BeshoySameh1/GRC-2026-ROV-BUE/ROV/WIN_20251121_15_10_11_Pro.jpg

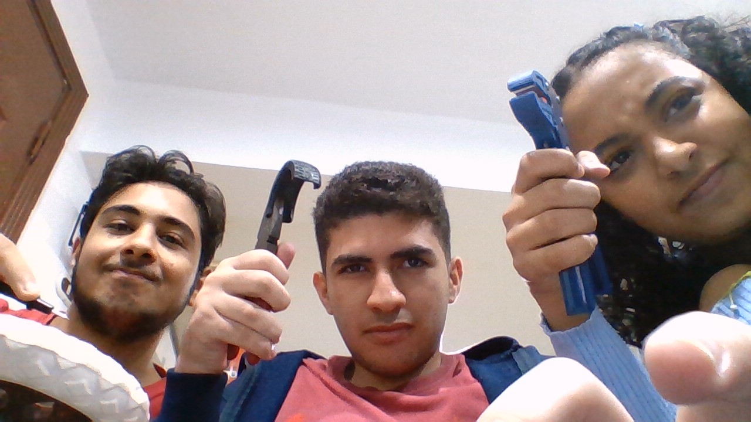
ROV/WIN_20251121_15_10_11_Pro.jpg
