BeshoySameh1/GRC-2026-ROV-BUE/ROV-Elec/NEW/Cntrol + comm/main control/silk.pdf

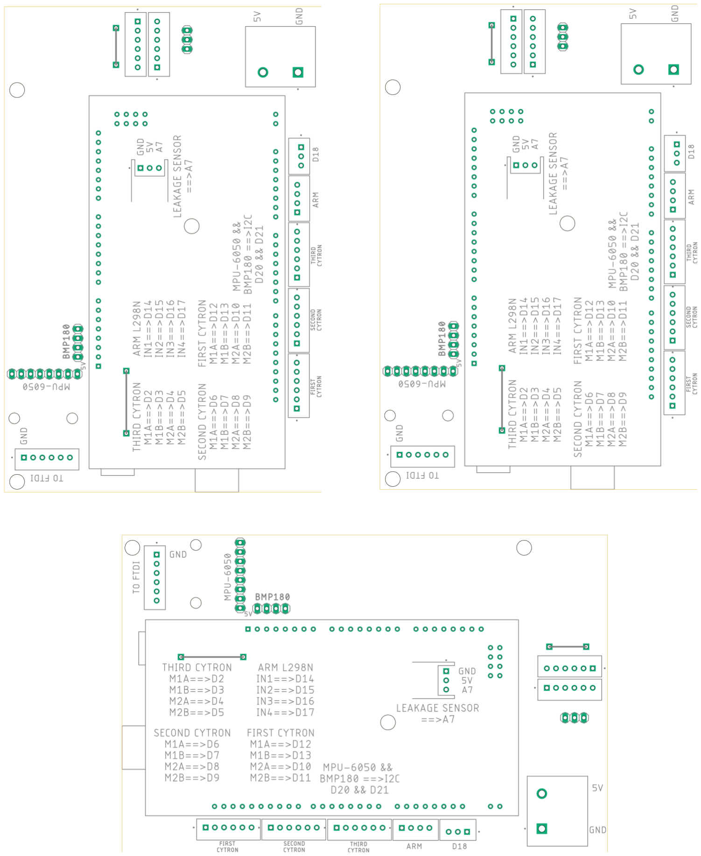
[picture p15: page 1]
