BeshoySameh1/GRC-2026-ROV-BUE/ROV-Elec/NEW/Cntrol + comm/main control/tracks.pdf

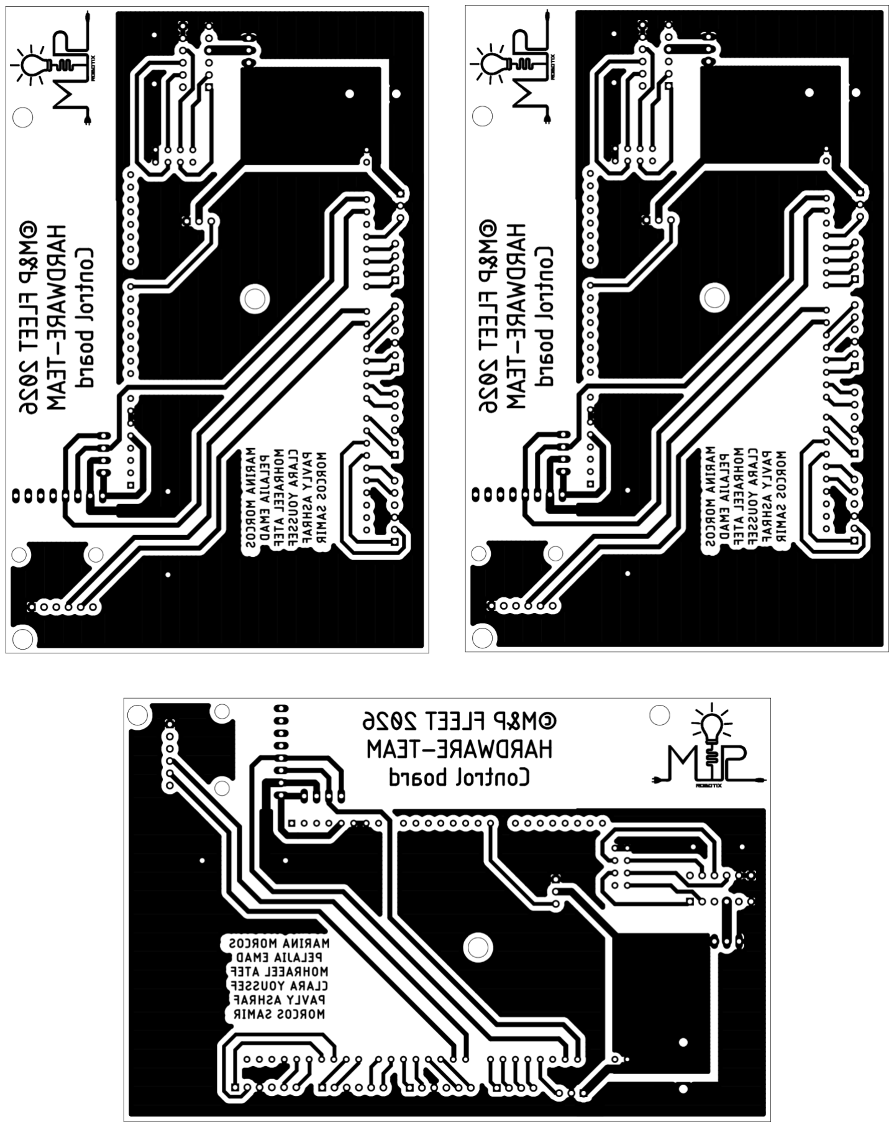
[picture p16: page 1]
