BeshoySameh1/GRC-2026-ROV-BUE/Cost Analysis (1).pdf

### Cost Overview

The total cost for the ROV components is 29,000 EGP and 580 USD, ensuring a
competitive pricing strategy for the Egyptian market in robotics applications.

### Component Breakdown

Major categories include
Propulsion, Electronics,
Cameras, Mechanical, Tether, and Manipulator, which together contribute to the effective performance of the ROV in
various underwater tasks.

### Market Adaptability

This cost analysis reflects local market conditions and allows for strategic adjustments to pricing, ensuring that our ROV remains accessible and
appealing to potential clients in Egypt.

# ROV Cost Analysis

### Detailed breakdown for Egypt market

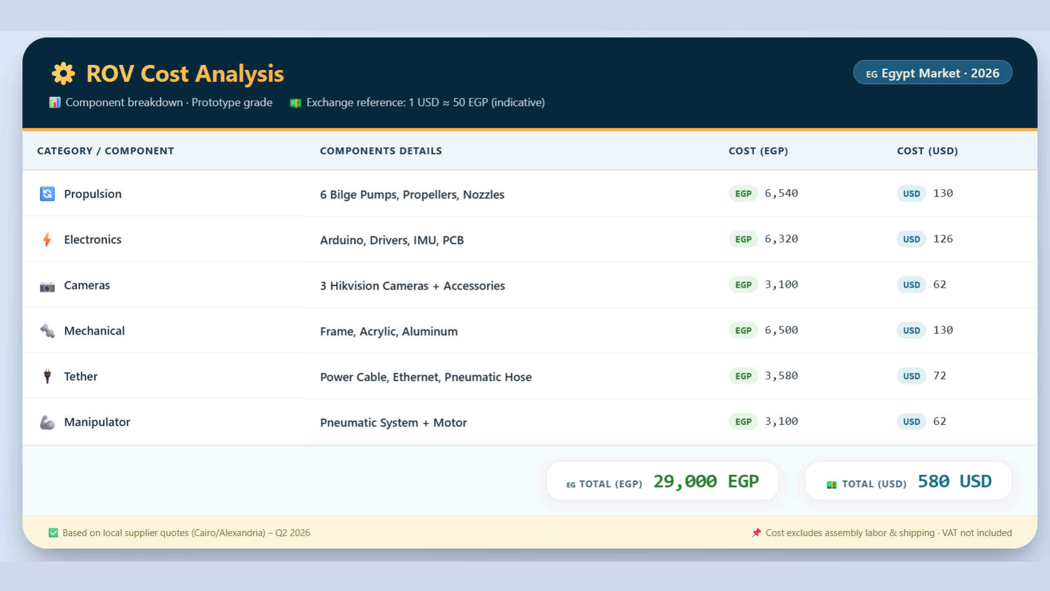
[picture p17: page 2]
