BeshoySameh1/GRC-2026-ROV-BUE/ROV-Elec/NEW/Cntrol + comm/spi module board/silk.pdf

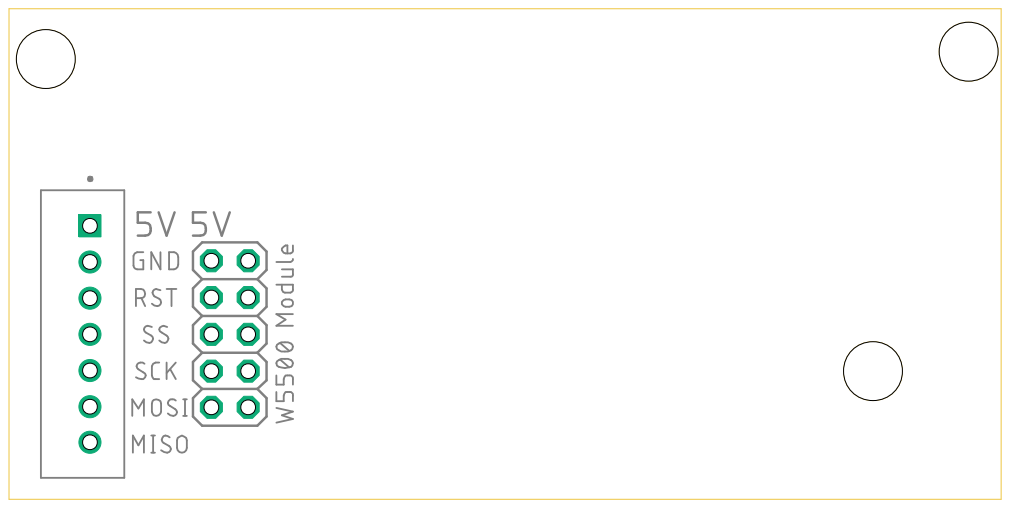
[picture p18: page 1]
