BeshoySameh1/GRC-2026-ROV-BUE/ROV-Elec/NEW/Cntrol + comm/spi module board/tracks.pdf

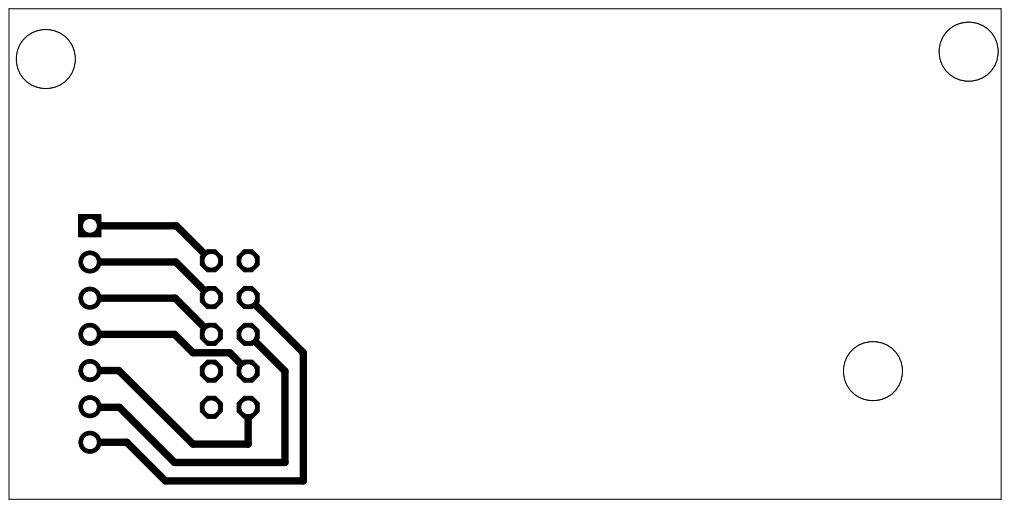
[picture p19: page 1]
