BeshoySameh1/GRC-2026-ROV-BUE/ROV-Elec/NEW/POWER/Main power/silk.pdf

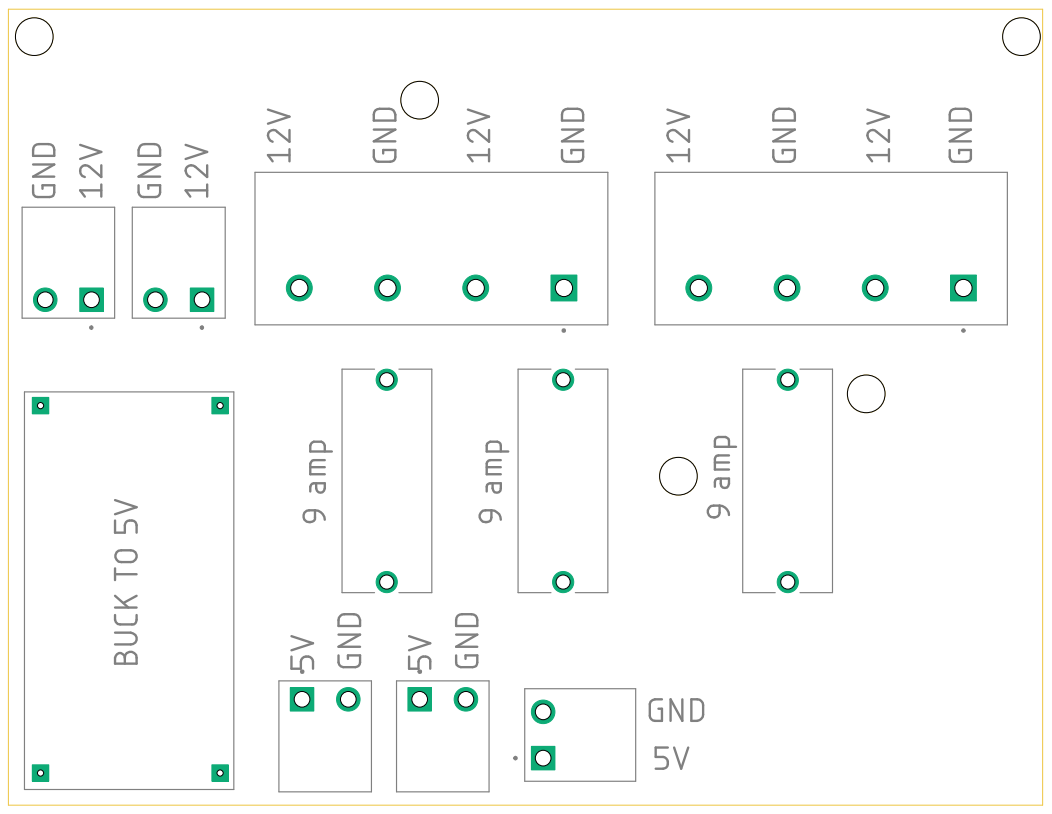
[picture p20: page 1]
