BeshoySameh1/GRC-2026-ROV-BUE/ROV-Elec/NEW/POWER/Main power/tracks.pdf

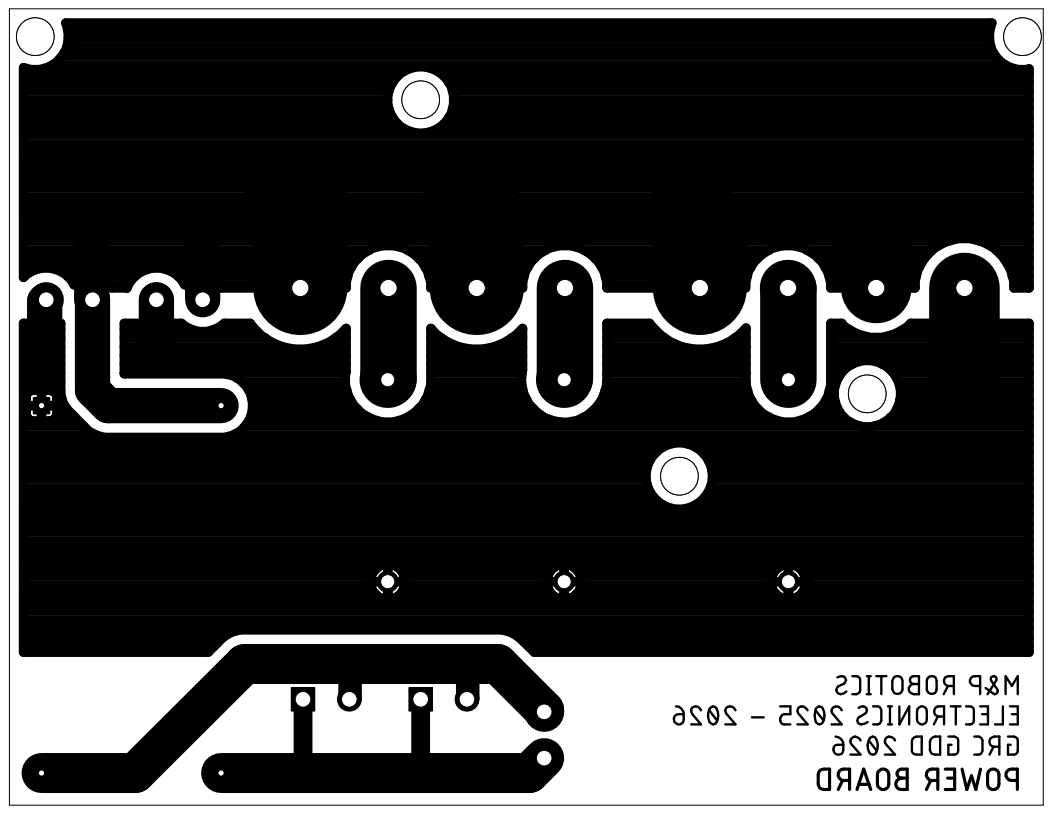
[picture p21: page 1]
