BeshoySameh1/GRC-2026-ROV-BUE/ROV-Elec/NEW/POWER/Camera power and board/at station/silk.pdf

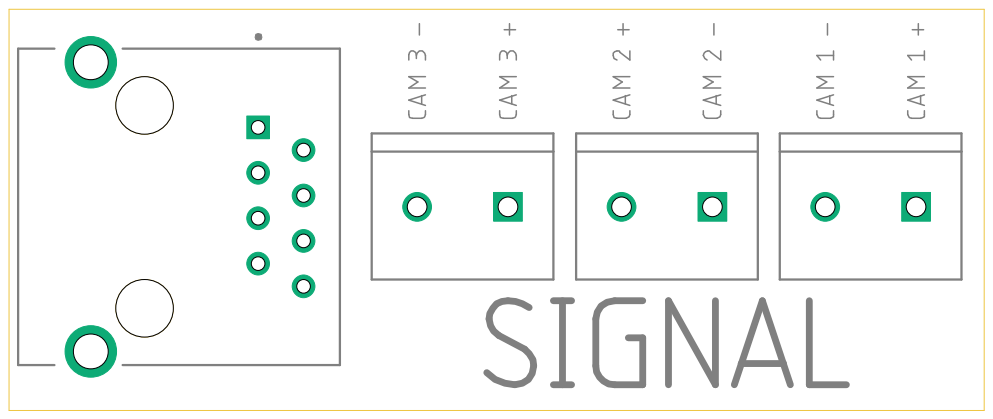
[picture p22: page 1]
