BeshoySameh1/GRC-2026-ROV-BUE/ROV-Elec/NEW/POWER/Camera power and board/at station/tracks.pdf

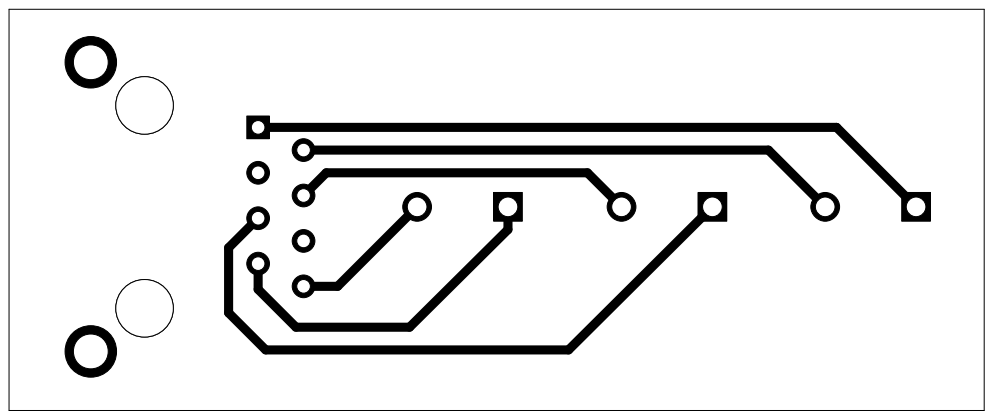
[picture p23: page 1]
