BeshoySameh1/GRC-2026-ROV-BUE/ROV-Elec/NEW/POWER/Camera power and board/in rov/silk.pdf

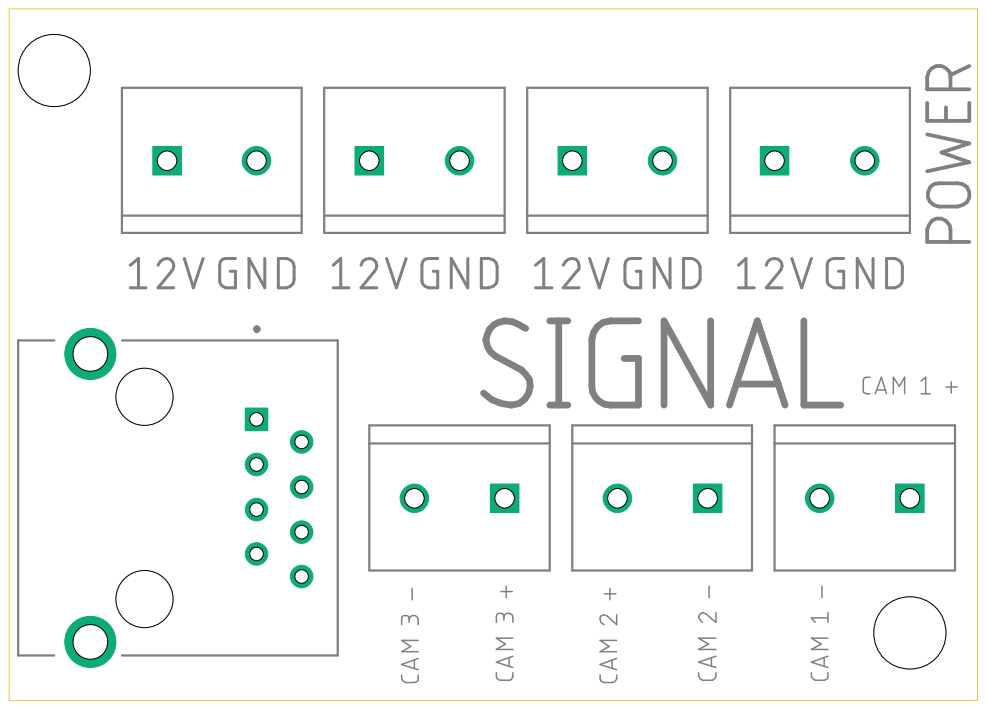
[picture p24: page 1]
