BeshoySameh1/GRC-2026-ROV-BUE/ROV-Elec/NEW/POWER/Camera power and board/in rov/tracks.pdf

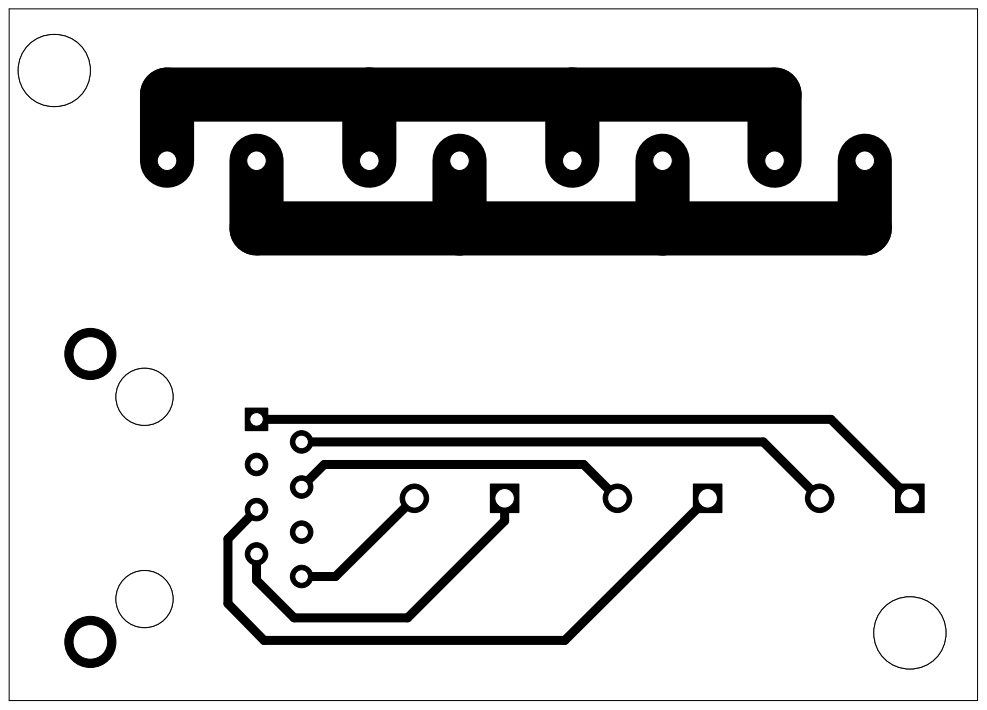
[picture p25: page 1]
