BeshoySameh1/GRC-2026-ROV-BUE/ROV/comm.brd

## EAGLE design ROV/comm.brd (2026-06-27)

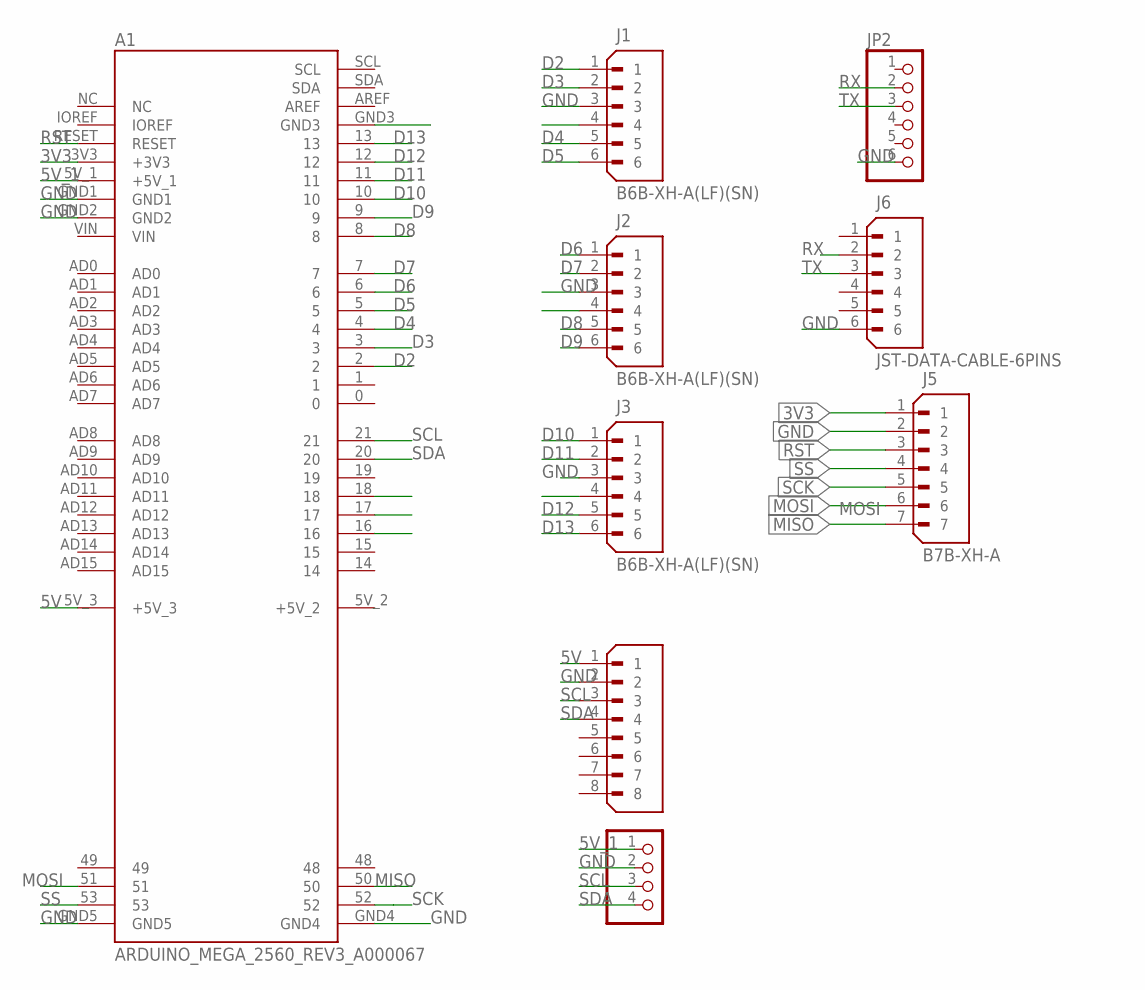
[picture p26: schematic comm.sch]

Parts:
A1: ARDUINO_MEGA_2560_REV3_A000067; ARDUINO_ARDUINO_MEGA_2560_REV3_A000067
J1, J2, J3: B6B-XH-A(LF)(SN); JST_B6B-XH-A(LF)(SN)
J4: B8B-XH-A(LF)(SN); JST_B8B-XH-A(LF)(SN)
J5: B7B-XH-A; JST_B7B-XH-A
J6: JST-DATA-CABLE-6PINS; JST_B6B-XH-A(LF)(SN)
JP1: PINHD-1X4; 1X04
JP2: PINHD-1X6; 1X06

Connections:
3V3: A1.3V3 (+3V3), J5.1
5V: A1.5V_3 (+5V_3), J4.1
5V_1: A1.5V_1 (+5V_1), JP1.1
D2: A1.2, J1.1
D3: A1.3, J1.2
D4: A1.4, J1.5
D5: A1.5, J1.6
D6: A1.6, J2.1
D7: A1.7, J2.2
D8: A1.8, J2.5
D9: A1.9, J2.6
D10: A1.10, J3.1
D11: A1.11, J3.2
D12: A1.12, J3.4, J3.5
D13: A1.13, J3.6
GND: A1.GND1, A1.GND2, A1.GND4, A1.GND5, J1.3, J2.3, J3.3, J4.2, J5.2, J6.6, JP1.2, JP2.6
MISO: A1.50, J5.7
MOSI: A1.51, J5.6
RST: A1.RESET, J5.3
RX: J6.2, JP2.2
SCK: A1.52, J5.5
SCL: A1.21, J4.3, JP1.3
SDA: A1.20, J4.4, JP1.4
SS: A1.53, J5.4
TX: J6.3, JP2.3

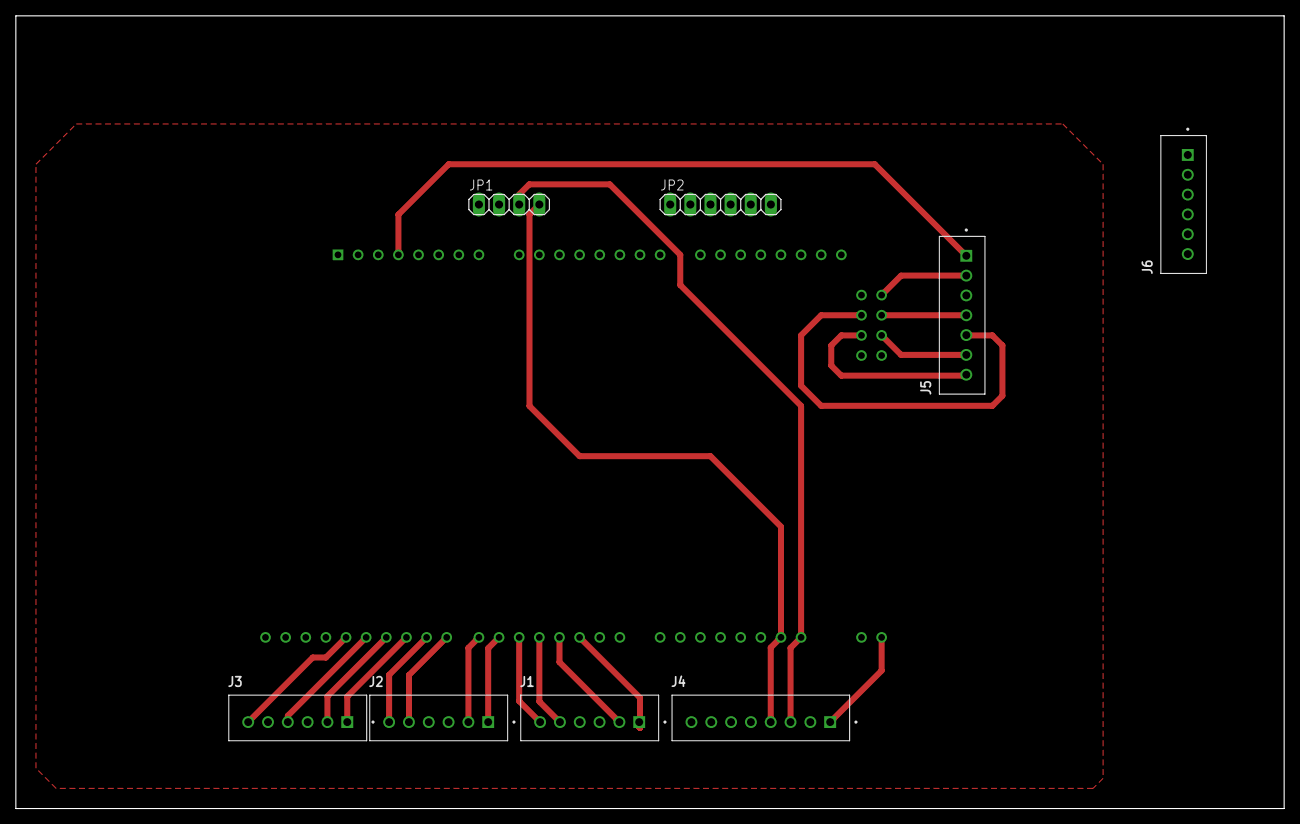
[picture p27: board comm.brd from above]

Board: 2 copper layers, 160.0 x 100.0 mm, 9 parts (1 on the bottom side), 25 nets.
