BeshoySameh1/GRC-2026-ROV-BUE/ROV/cam/untitled.brd

## EAGLE design ROV/cam/untitled.brd (2026-06-27)

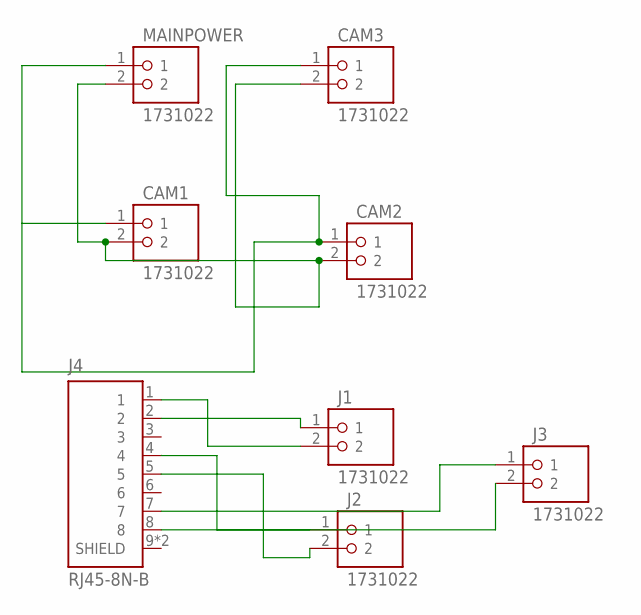
[picture p28: schematic untitled.sch]

Parts:
CAM1, CAM2, CAM3: 1731022; PHOENIX_1731022
J1, J2, J3: 1731022; PHOENIX_1731022
J4: RJ45-8N-B; TE_RJ45-8N-B
MAINPOWER: 1731022; PHOENIX_1731022

Connections:
12V: CAM1.1, CAM2.1, CAM3.1, MAINPOWER.1
GND: CAM1.2, CAM2.2, CAM3.2, MAINPOWER.2
unnamed: J1.1, J4.2
unnamed: J1.2, J4.1
unnamed: J2.1, J4.4
unnamed: J2.2, J4.5
unnamed: J3.1, J4.7
unnamed: J3.2, J4.8

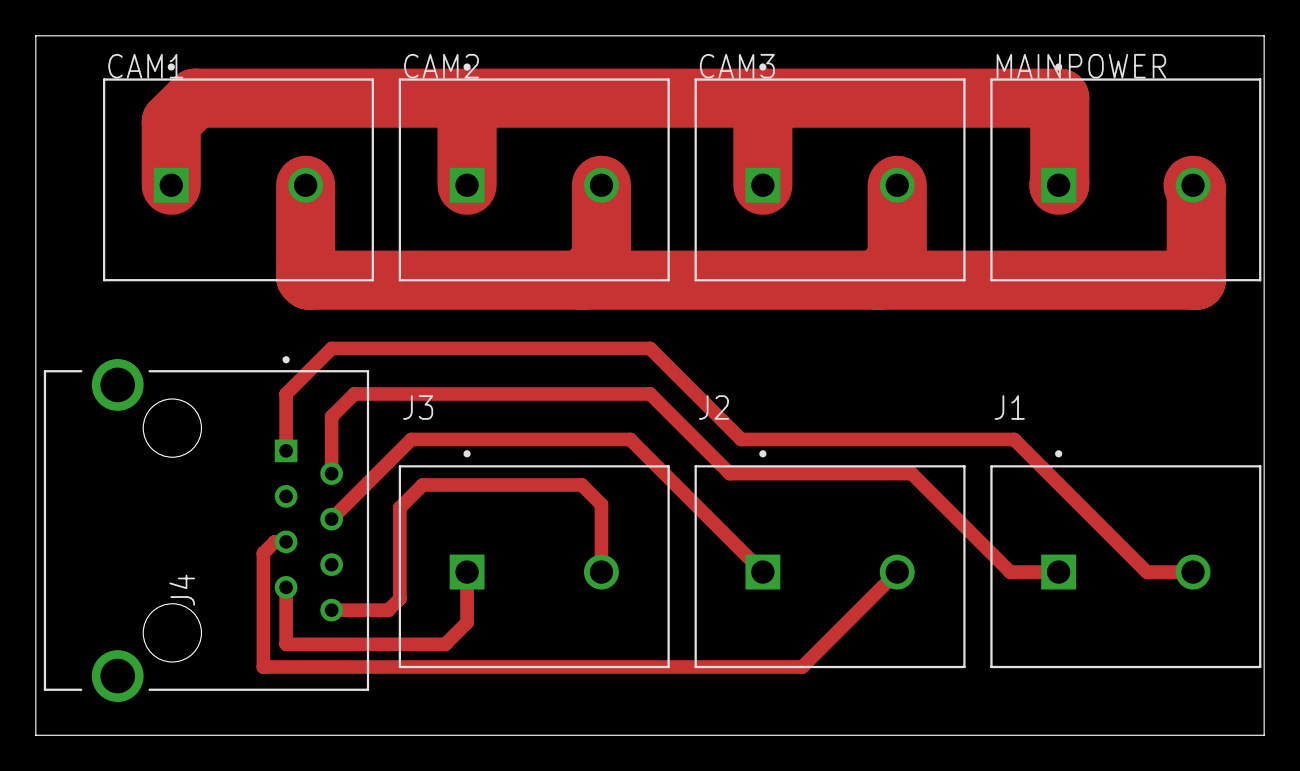
[picture p29: board untitled.brd from above]

Board: 2 copper layers, 68.6 x 39.0 mm, 8 parts (0 on the bottom side), 8 nets.
