BeshoySameh1/GRC-2026-ROV-BUE/ROV/power.brd

## EAGLE design ROV/power.brd (2026-06-27)

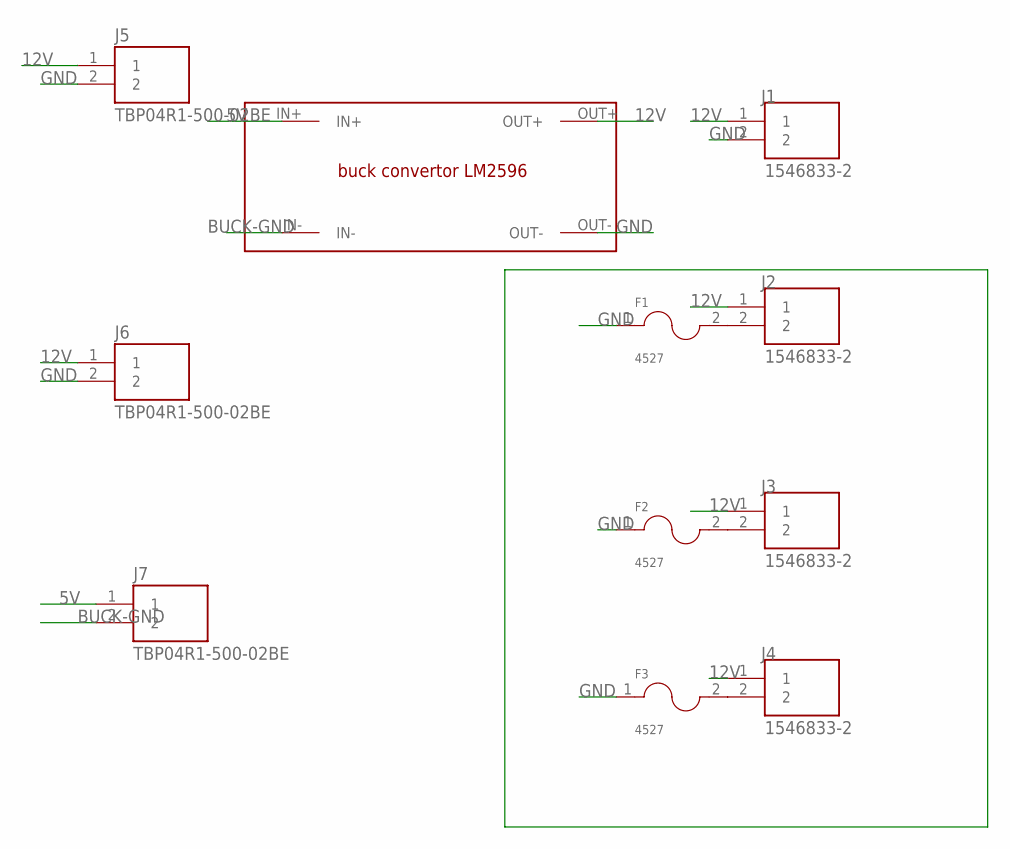
[picture p30: schematic power.sch]

Parts:
F1, F2, F3: 4527; FUSE_4527
J1, J2, J3, J4: 1546833-2; TE_1546833-2
J5, J6, J7: TBP04R1-500-02BE; CUI_TBP04R1-500-02BE
U$1: LM2596

Connections:
5V: J7.1, U$1.IN+
12V: J1.1, J2.1, J3.1, J4.1, J5.1, J6.1, U$1.OUT+
BUCK-GND: J7.2, U$1.IN-
GND: F1.1, F2.1, F3.1, J1.2, J5.2, J6.2, U$1.OUT-
unnamed: F1.2, J2.2
unnamed: F2.2, J3.2
unnamed: F3.2, J4.2

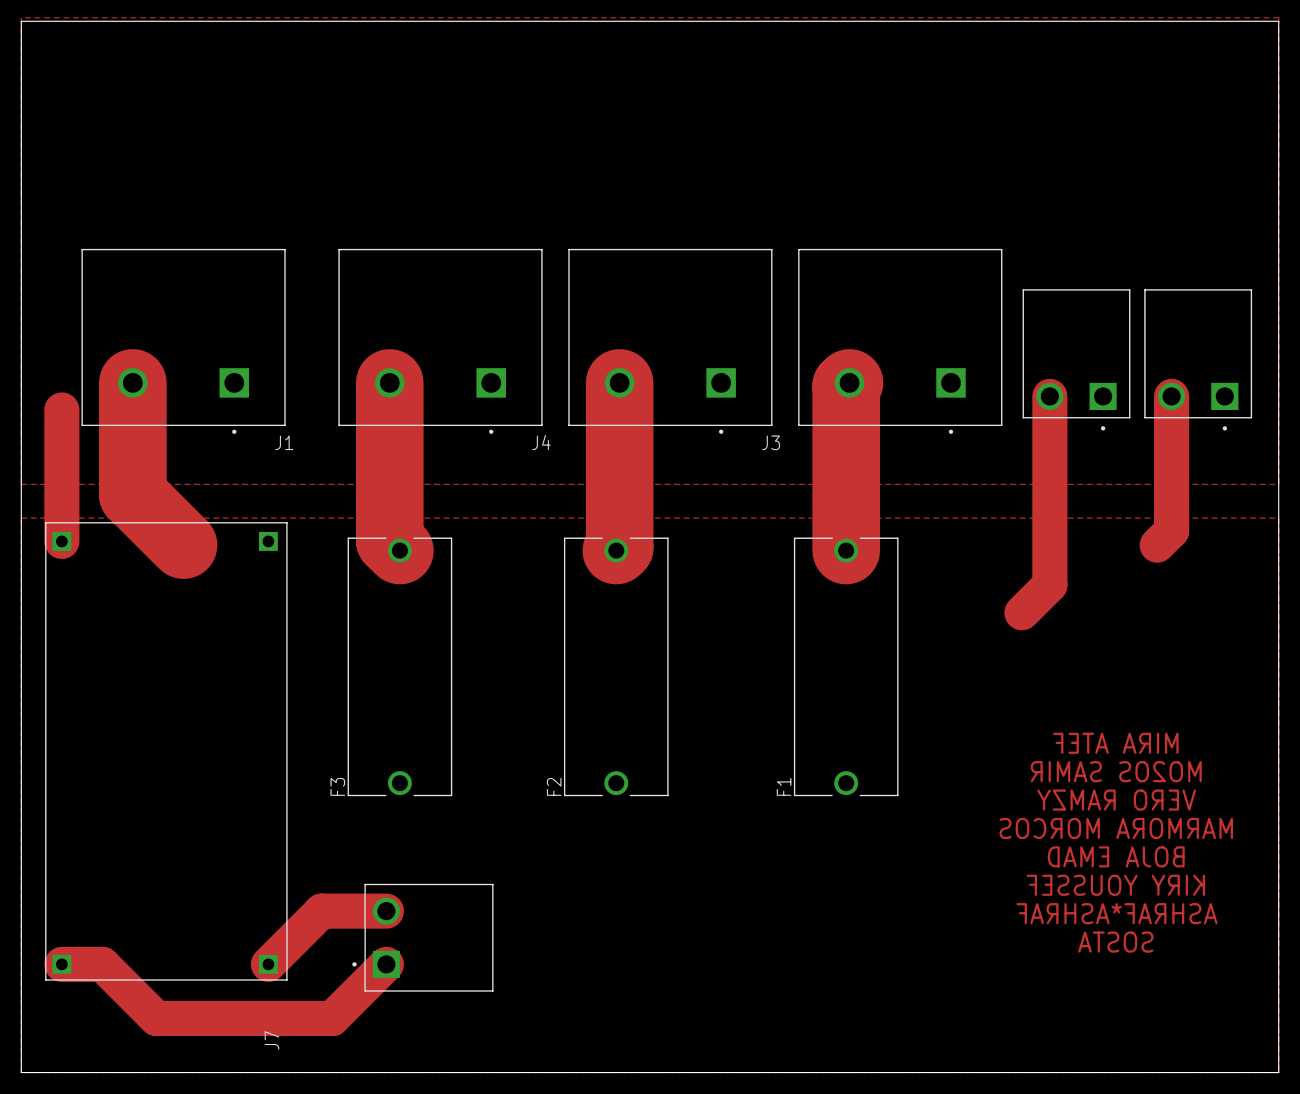
[picture p31: board ROV/power.brd from above]

Board: 2 copper layers, 118.1 x 98.7 mm, 11 parts (0 on the bottom side), 7 nets.
