BeshoySameh1/GRC-2026-ROV-BUE/ROV-Elec/NEW/POWER/Camera power and board/at station/camera.brd

## EAGLE design ROV-Elec/NEW/POWER/Camera power and board/at station/camera.brd (2026-06-27)

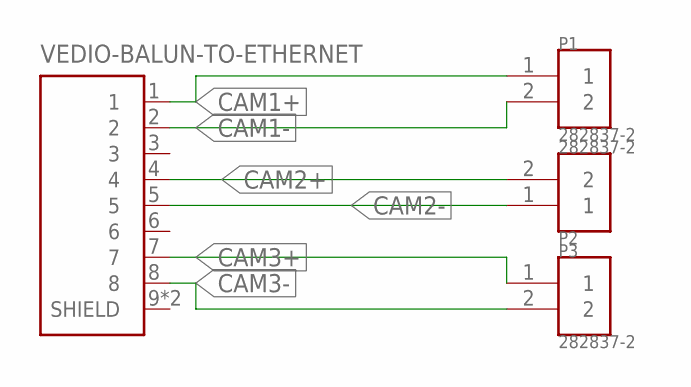
[picture p32: schematic camera.sch, vedio balun to ethernet]

Parts:
P1, P2, P3: 282837-2; TE_282837-2
VEDIO-BALUN-TO-ETHERNET: RJ45-8N-B; TE_RJ45-8N-B

Connections:
CAM1+: P1.1, VEDIO-BALUN-TO-ETHERNET.1
CAM1-: P1.2, VEDIO-BALUN-TO-ETHERNET.2
CAM2+: P2.2, VEDIO-BALUN-TO-ETHERNET.4
CAM2-: P2.1, VEDIO-BALUN-TO-ETHERNET.5
CAM3+: P3.1, VEDIO-BALUN-TO-ETHERNET.7
CAM3-: P3.2, VEDIO-BALUN-TO-ETHERNET.8

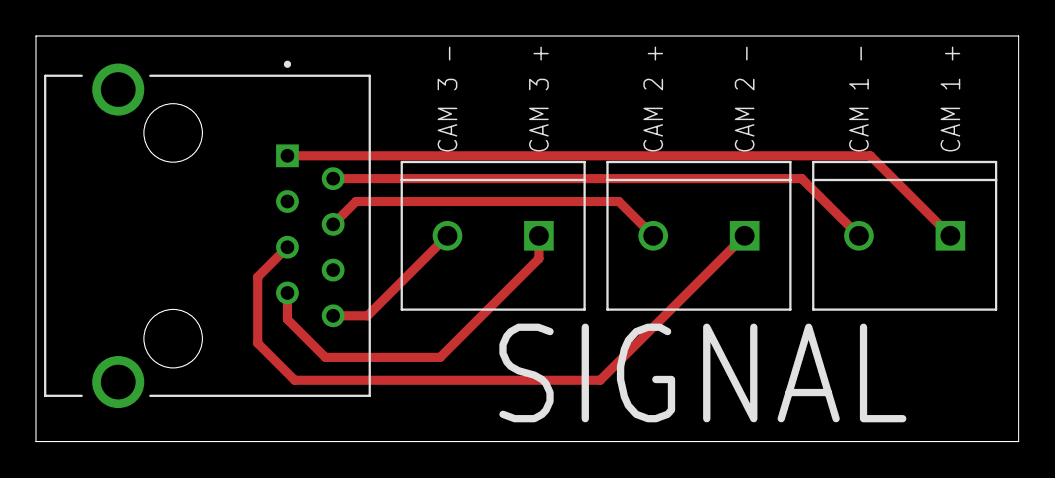
[picture p33: board camera.brd from above]

Board: 2 copper layers, 54.6 x 22.5 mm, 4 parts (0 on the bottom side), 6 nets.
