BeshoySameh1/GRC-2026-ROV-BUE/ROV-Elec/NEW/POWER/Main power/power.brd

## EAGLE design ROV-Elec/NEW/POWER/Main power/power.brd (2026-06-27)

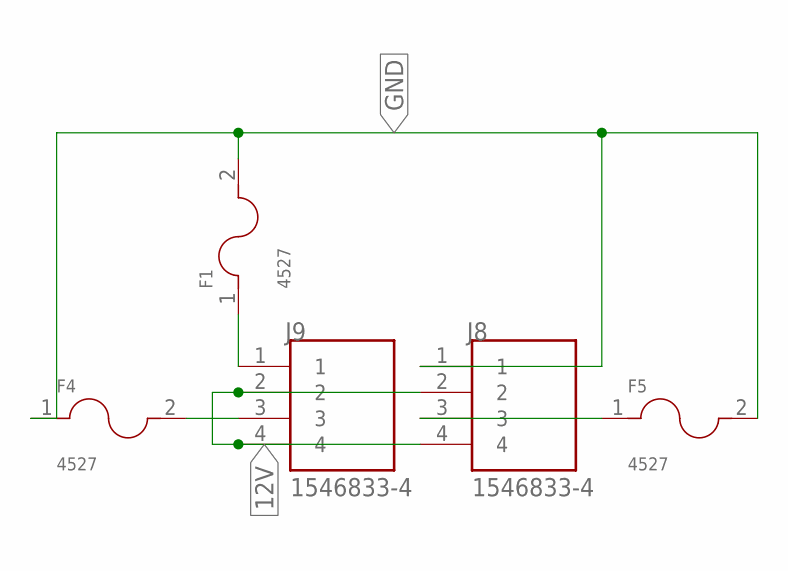
[picture p34: schematic power.sch, sheet 2, thrusters power]

Parts:
F1, F4, F5: 4527; FUSE_4527
J8, J9: 1546833-4; TE_1546833-4

Connections:
12V: J8.2, J8.4, J9.2, J9.4; also elsewhere on the board
GND: F1.2, F4.1, F5.2, J8.1; also elsewhere on the board
unnamed: F4.2, J9.3
unnamed: F5.1, J8.3
unnamed: F1.1, J9.1

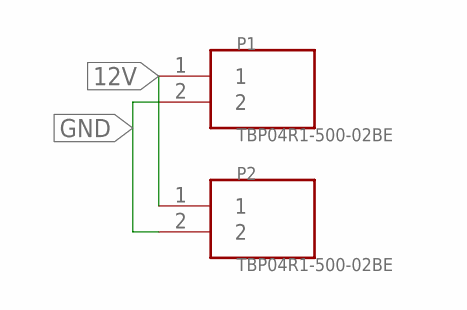
[picture p35: schematic power.sch, sheet 3, arm power + cameras power]

Parts:
P1, P2: TBP04R1-500-02BE; CUI_TBP04R1-500-02BE

Connections:
12V: P1.1, P2.1; also elsewhere on the board
GND: P1.2, P2.2; also elsewhere on the board

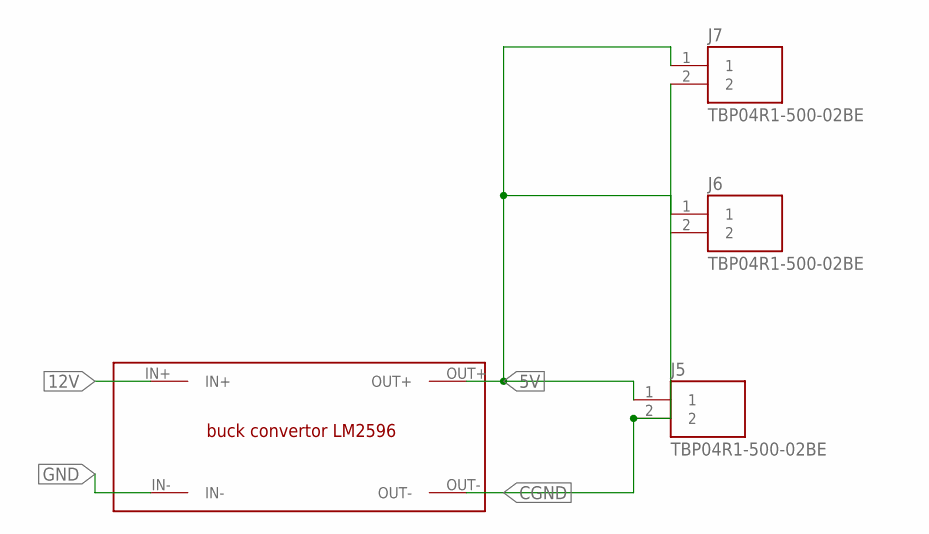
[picture p36: schematic power.sch, sheet 4, control power]

Parts:
J5, J6, J7: TBP04R1-500-02BE; CUI_TBP04R1-500-02BE
U$1: LM2596

Connections:
5V: J5.1, J6.1, J7.1, U$1.OUT+
12V: U$1.IN+; also elsewhere on the board
CGND: J5.2, J6.2, J7.2, U$1.OUT-
GND: U$1.IN-; also elsewhere on the board

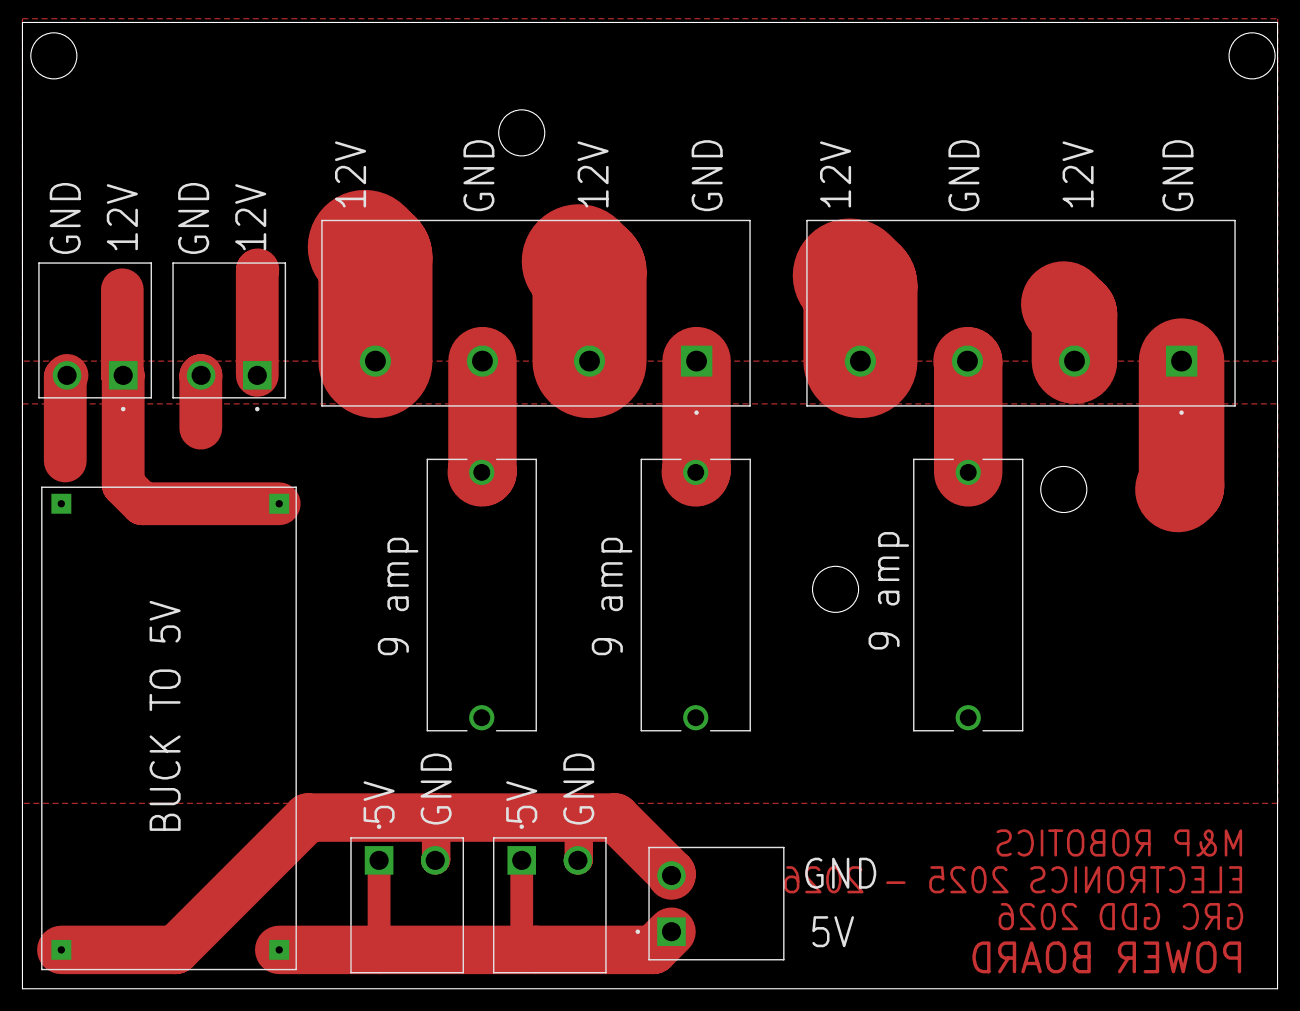
[picture p37: board ROV-Elec/NEW/POWER/Main power/power.brd from above]

Board: 2 copper layers, 111.7 x 86.0 mm, 11 parts (0 on the bottom side), 7 nets.
