BeshoySameh1/GRC-2026-ROV-BUE/ROV-Elec/NEW/Cntrol + comm/main control/coaches.brd

## EAGLE design ROV-Elec/NEW/Cntrol + comm/main control/coaches.brd (2026-06-27)

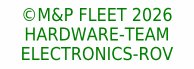
[picture p38: schematic coaches.sch, sheet 1, BIO]

Notes on the sheet:
©M&P FLEET 2026 HARDWARE-TEAM ELECTRONICS-ROV

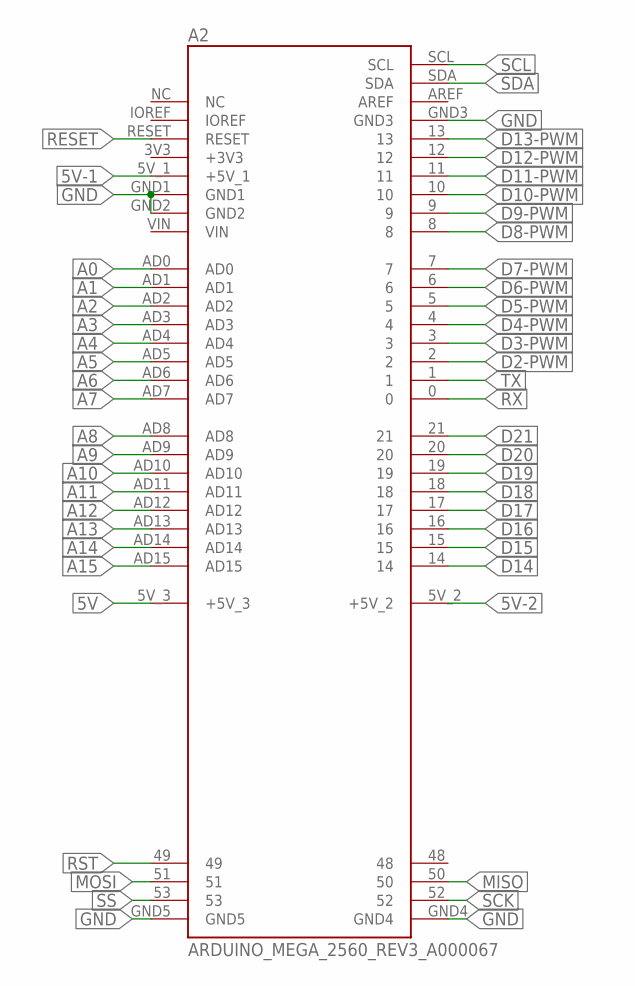
[picture p39: schematic coaches.sch, sheet 2, ARDUINO MEGA]

Parts:
A2: ARDUINO_MEGA_2560_REV3_A000067; ARDUINO_ARDUINO_MEGA_2560_REV3_A000067

Connections:
5V: A2.5V_3 (+5V_3); also elsewhere on the board
5V-1: A2.5V_1 (+5V_1); also elsewhere on the board
5V-2: A2.5V_2 (+5V_2)
A0: A2.AD0
A1: A2.AD1
A2: A2.AD2
A3: A2.AD3
A4: A2.AD4
A5: A2.AD5
A6: A2.AD6
A7: A2.AD7; also elsewhere on the board
A8: A2.AD8
A9: A2.AD9
A10: A2.AD10
A11: A2.AD11
A12: A2.AD12
A13: A2.AD13
A14: A2.AD14
A15: A2.AD15
D2-PWM: A2.2; also elsewhere on the board
D3-PWM: A2.3; also elsewhere on the board
D4-PWM: A2.4; also elsewhere on the board
D5-PWM: A2.5; also elsewhere on the board
D6-PWM: A2.6; also elsewhere on the board
D7-PWM: A2.7; also elsewhere on the board
D8-PWM: A2.8; also elsewhere on the board
D9-PWM: A2.9; also elsewhere on the board
D10-PWM: A2.10; also elsewhere on the board
D11-PWM: A2.11; also elsewhere on the board
D12-PWM: A2.12; also elsewhere on the board
D13-PWM: A2.13; also elsewhere on the board
D14: A2.14; also elsewhere on the board
D15: A2.15; also elsewhere on the board
D16: A2.16; also elsewhere on the board
D17: A2.17; also elsewhere on the board
D18: A2.18; also elsewhere on the board
D19: A2.19
D20: A2.20; also elsewhere on the board
D21: A2.21; also elsewhere on the board
GND: A2.GND1, A2.GND2, A2.GND3, A2.GND4, A2.GND5; also elsewhere on the board
MISO: A2.50; also elsewhere on the board
MOSI: A2.51; also elsewhere on the board
RESET: A2.RESET
RST: A2.49; also elsewhere on the board
RX: A2.0; also elsewhere on the board
SCK: A2.52; also elsewhere on the board
SCL: A2.SCL
SDA: A2.SDA
SS: A2.53; also elsewhere on the board
TX: A2.1; also elsewhere on the board

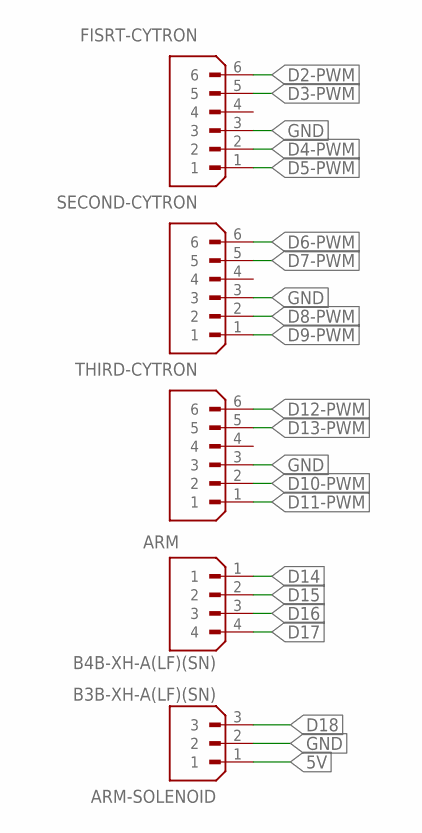
[picture p40: schematic coaches.sch, sheet 3, Motors]

Parts:
ARM: B4B-XH-A(LF)(SN); JST_B4B-XH-A(LF)(SN)
ARM-SOLENOID: B3B-XH-A(LF)(SN); JST_B3B-XH-A(LF)(SN)
FISRT-CYTRON: B6B-XH-A(LF)(SN); JST_B6B-XH-A(LF)(SN)
SECOND-CYTRON: B6B-XH-A(LF)(SN); JST_B6B-XH-A(LF)(SN)
THIRD-CYTRON: B6B-XH-A(LF)(SN); JST_B6B-XH-A(LF)(SN)

Connections:
5V: ARM-SOLENOID.1; also elsewhere on the board
D2-PWM: FISRT-CYTRON.6; also elsewhere on the board
D3-PWM: FISRT-CYTRON.5; also elsewhere on the board
D4-PWM: FISRT-CYTRON.2; also elsewhere on the board
D5-PWM: FISRT-CYTRON.1; also elsewhere on the board
D6-PWM: SECOND-CYTRON.6; also elsewhere on the board
D7-PWM: SECOND-CYTRON.5; also elsewhere on the board
D8-PWM: SECOND-CYTRON.2; also elsewhere on the board
D9-PWM: SECOND-CYTRON.1; also elsewhere on the board
D10-PWM: THIRD-CYTRON.2; also elsewhere on the board
D11-PWM: THIRD-CYTRON.1; also elsewhere on the board
D12-PWM: THIRD-CYTRON.6; also elsewhere on the board
D13-PWM: THIRD-CYTRON.5; also elsewhere on the board
D14: ARM.1; also elsewhere on the board
D15: ARM.2; also elsewhere on the board
D16: ARM.3; also elsewhere on the board
D17: ARM.4; also elsewhere on the board
D18: ARM-SOLENOID.3; also elsewhere on the board
GND: ARM-SOLENOID.2, FISRT-CYTRON.3, SECOND-CYTRON.3, THIRD-CYTRON.3; also elsewhere on the board

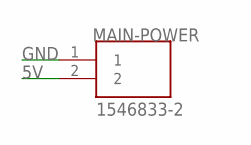
[picture p41: schematic coaches.sch, sheet 4, power plan]

Parts:
MAIN-POWER: 1546833-2; TE_1546833-2

Connections:
5V: MAIN-POWER.2; also elsewhere on the board
GND: MAIN-POWER.1; also elsewhere on the board

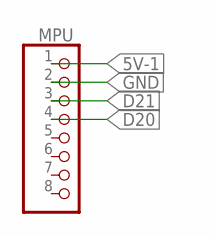
[picture p42: schematic coaches.sch, sheet 5, MPU]

Parts:
MPU: PINHD-1X8; 1X08

Connections:
5V-1: MPU.1; also elsewhere on the board
D20: MPU.4; also elsewhere on the board
D21: MPU.3; also elsewhere on the board
GND: MPU.2; also elsewhere on the board

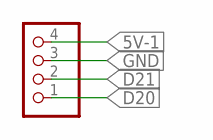
[picture p43: schematic coaches.sch, sheet 6, BMP180 GY-68 Barometric Pressure Sensor]

Parts:
PROMETER: PINHD-1X4; 1X04

Connections:
5V-1: PROMETER.4; also elsewhere on the board
D20: PROMETER.1; also elsewhere on the board
D21: PROMETER.2; also elsewhere on the board
GND: PROMETER.3; also elsewhere on the board

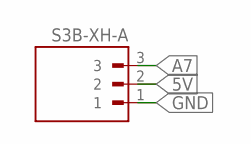
[picture p44: schematic coaches.sch, sheet 7, LEAKAGE SENSOR]

Parts:
J3: S3B-XH-A; JST_S3B-XH-A

Connections:
5V: J3.2; also elsewhere on the board
A7: J3.3; also elsewhere on the board
GND: J3.1; also elsewhere on the board

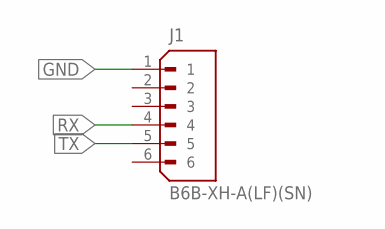
[picture p45: schematic coaches.sch, sheet 8, to FTDI]

Parts:
J1: B6B-XH-A(LF)(SN); JST_B6B-XH-A(LF)(SN)

Connections:
GND: J1.1; also elsewhere on the board
RX: J1.4; also elsewhere on the board
TX: J1.5; also elsewhere on the board
