BeshoySameh1/GRC-2026-ROV-BUE/ROV-Elec/NEW/Cntrol + comm/main control/coaches.brd

## EAGLE design ROV-Elec/NEW/Cntrol + comm/main control/coaches.brd (continued)

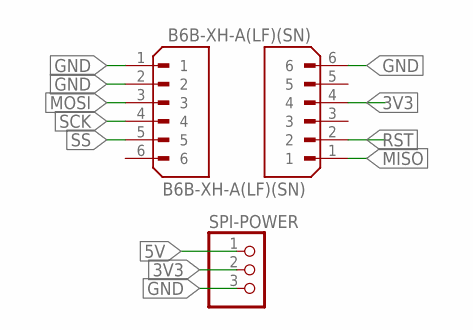
[picture p46: schematic coaches.sch, sheet 9, to spi]

Parts:
J2, J4: B6B-XH-A(LF)(SN); JST_B6B-XH-A(LF)(SN)
SPI-POWER: PINHD-1X3; 1X03

Connections:
3V3: J4.4, SPI-POWER.2
5V: SPI-POWER.1; also elsewhere on the board
GND: J2.1, J2.2, J4.6, SPI-POWER.3; also elsewhere on the board
MISO: J4.1; also elsewhere on the board
MOSI: J2.3; also elsewhere on the board
RST: J4.2; also elsewhere on the board
SCK: J2.4; also elsewhere on the board
SS: J2.5; also elsewhere on the board

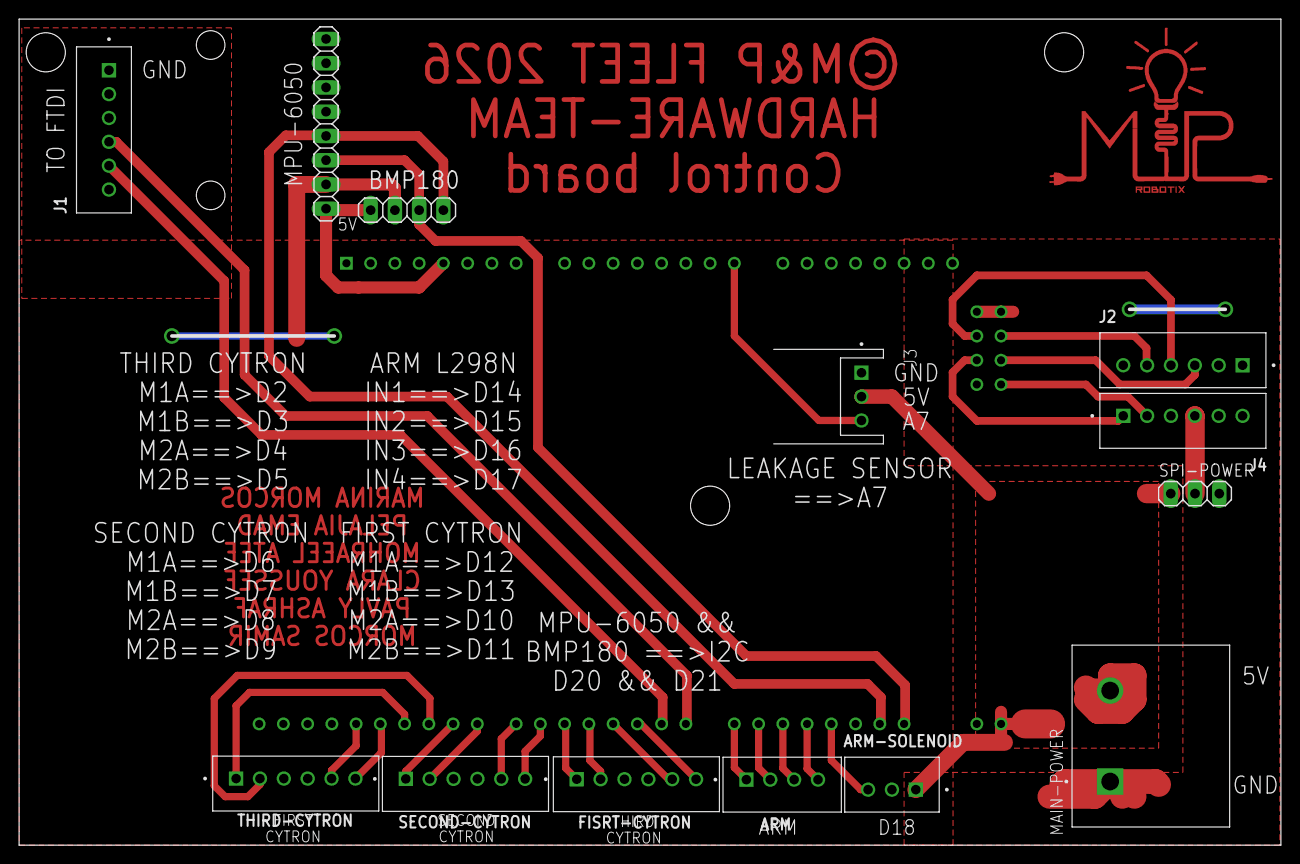
[picture p47: board coaches.brd from above]

Board: 2 copper layers, 132.2 x 86.5 mm, 14 parts (1 on the bottom side), 31 nets.
